ben5049/Robotics-101-Devkit/PCB/101 PCB/101 Models/SK34-TP.stp

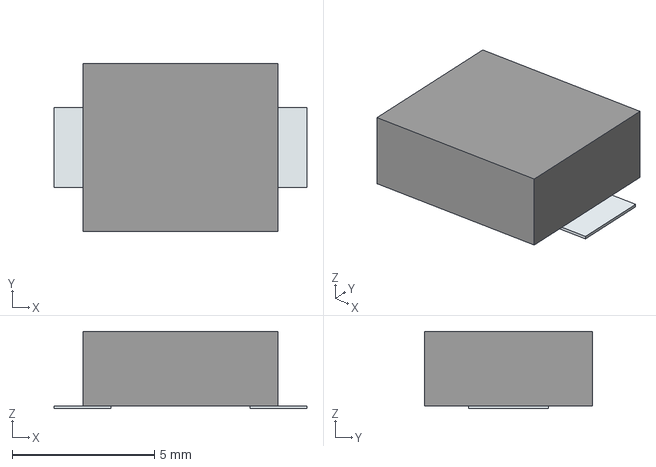
[picture p1: CAD file, 2023-09-11]
PCB/101 PCB/101 Models/SK34-TP.stp
8.90 x 5.90 x 2.72 mm
Pins
