ben5049/Robotics-101-Devkit/PCB/101 PCB/101 Models/DMP3028LFDE-13.STEP

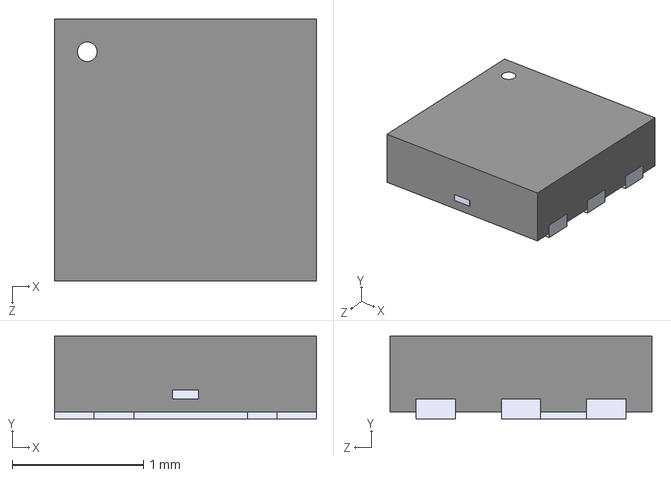
[picture p2: CAD file, 2023-07-07]
PCB/101 PCB/101 Models/DMP3028LFDE-13.STEP
2.00 x 0.63 x 2.00 mm
