ben5049/Robotics-101-Devkit/PCB/101 PCB/101 Models/STM32G030F6P6.stp

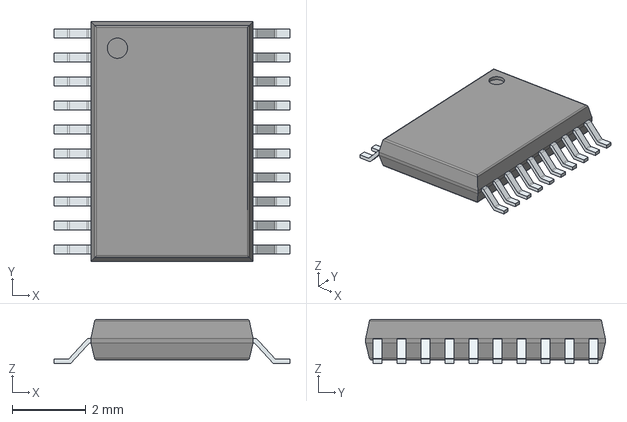
[picture p3: CAD file, 2023-07-05]
PCB/101 PCB/101 Models/STM32G030F6P6.stp
6.40 x 6.50 x 1.20 mm
PinsArrayLR
