ben5049/Robotics-101-Devkit/PCB/101 PCB/101 Models/DRV8837DSGR.stp

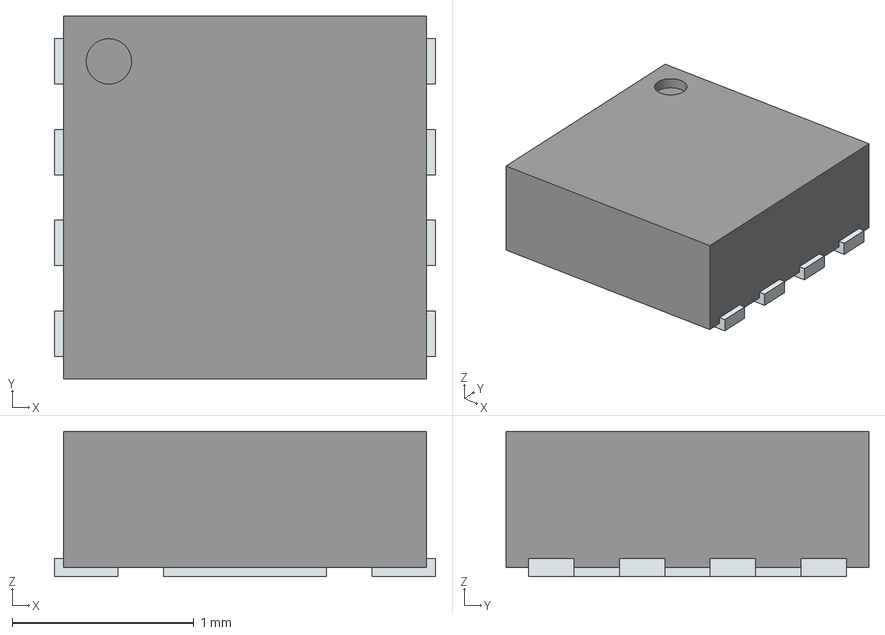
[picture p4: CAD file, 2023-07-05]
PCB/101 PCB/101 Models/DRV8837DSGR.stp
2.10 x 2.00 x 0.8 mm
ThermalPin
PinsArrayLR
