ben5049/Robotics-101-Devkit/PCB/101 PCB/101 Models/ESP32-WROVER-I--3DModel-STEP-56544.STEP

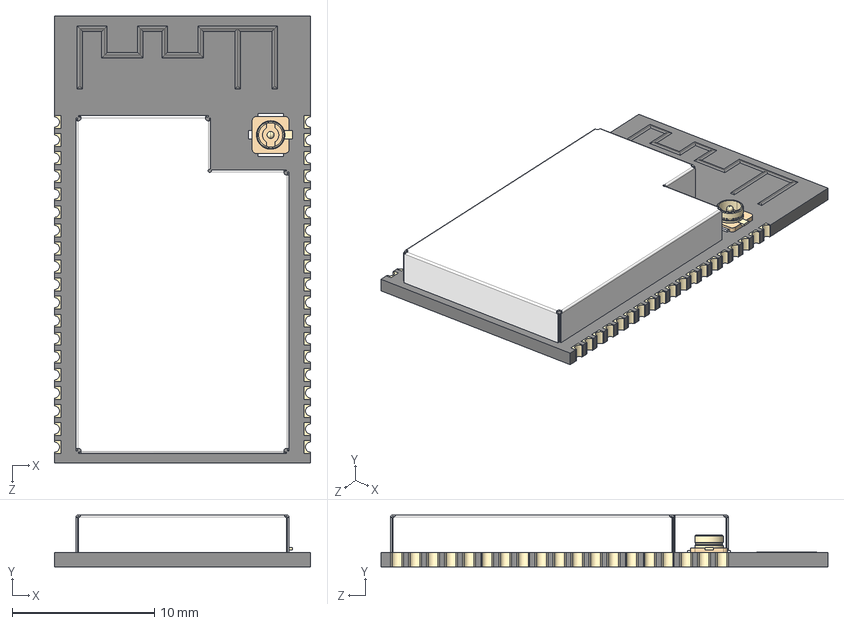
[picture p5: CAD file, 2023-07-05]
PCB/101 PCB/101 Models/ESP32-WROVER-I--3DModel-STEP-56544.STEP
18.0 x 3.65 x 31.4 mm
