ben5049/Robotics-101-Devkit/PCB/101 PCB/101 Models/TYPE-C-31-M-12.step

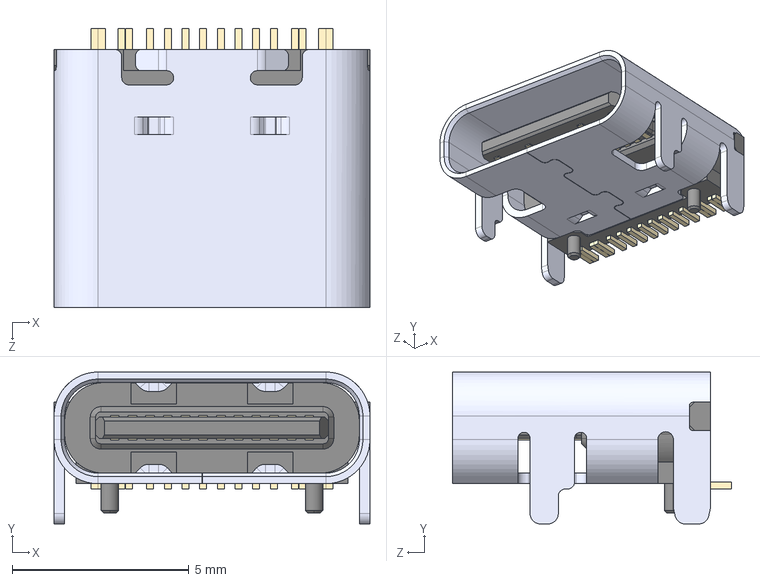
[picture p6: CAD file, 2023-07-05]
PCB/101 PCB/101 Models/TYPE-C-31-M-12.step
8.94 x 4.30 x 7.90 mm
