ben5049/Robotics-101-Devkit/PCB/101 PCB/101 Models/Screw-Terminal-P5.08.step

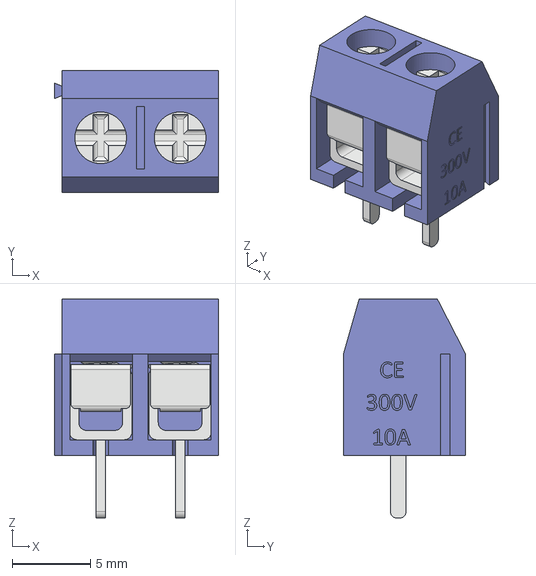
[picture p7: CAD file, 2023-09-11]
PCB/101 PCB/101 Models/Screw-Terminal-P5.08.step
10.5 x 7.80 x 14.0 mm
