ben5049/Robotics-101-Devkit/PCB/101 PCB/101 Models/1760510000.stp

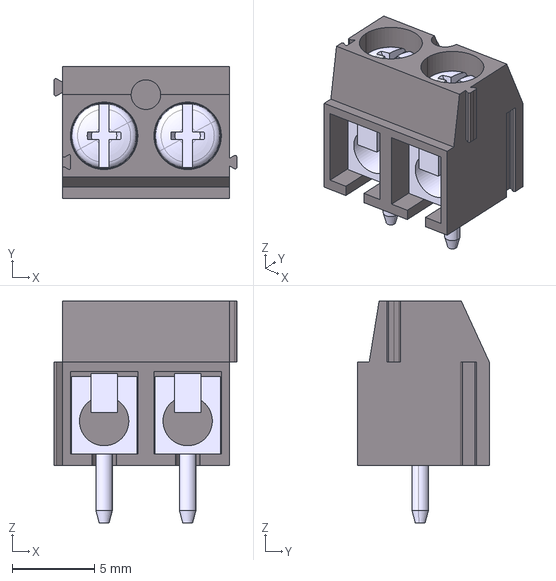
[picture p8: CAD file, 2023-07-05]
PCB/101 PCB/101 Models/1760510000.stp
11.1 x 8.00 x 13.5 mm
