ben5049/Robotics-101-Devkit/PCB/101 PCB/101 Models/TPS563202DRLR.stp

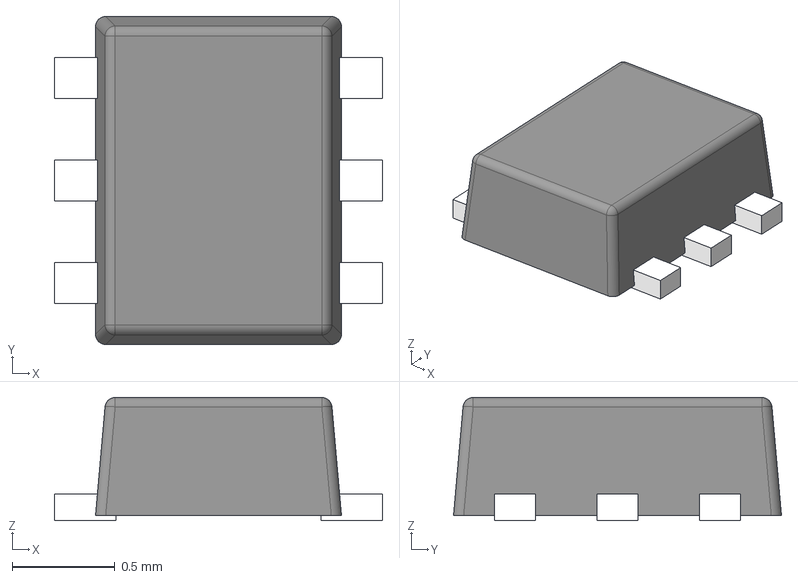
[picture p9: CAD file, 2023-07-05]
PCB/101 PCB/101 Models/TPS563202DRLR.stp
1.60 x 1.60 x 0.6 mm
FRAME-DRL0006A
BODY-SOT
PIN1-ID
