ben5049/Robotics-101-Devkit/PCB/101 PCB/101 PCB.kicad_pcb

## KiCad design PCB/101 PCB/101 PCB.kicad_pcb (2023-09-11)

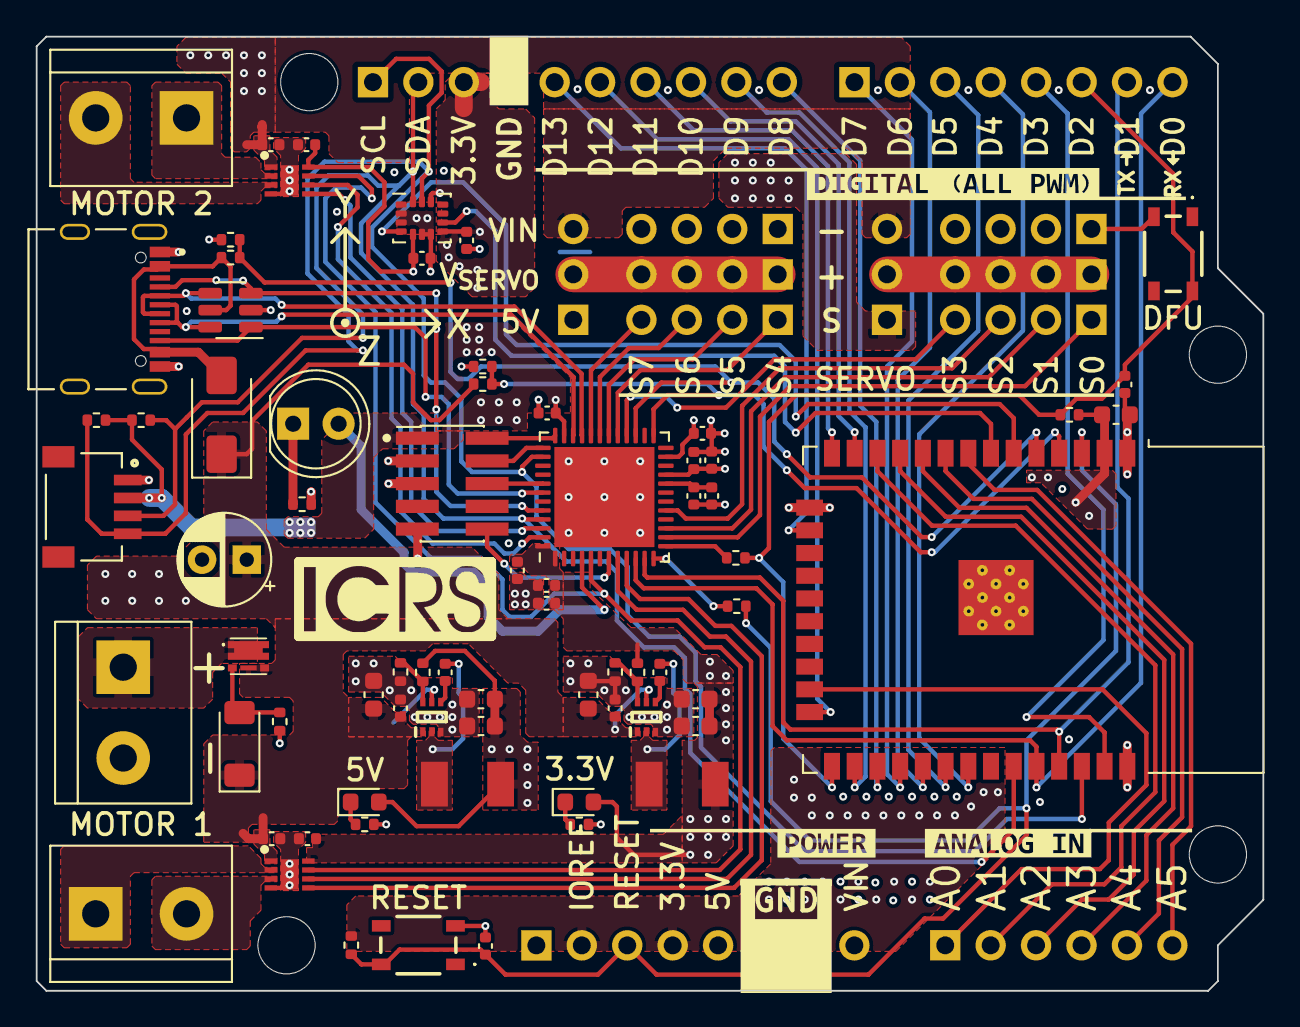
[picture p10: board 101 PCB.kicad_pcb from above]

Board: 4 copper layers, 68.6 x 53.3 mm, 84 parts (1 on the bottom side), 74 nets.

Parts:
A101: Arduino_UNO_R3; ICRS_101_UNO_R3_NO_PINS
C1, C101, C102, C107, C108, C111, C112, C113, C114, C115, C116, C117, C118, C120, C121, C122, C123, C126: 100n; C_0402_1005Metric
C2, C103, C104, C105, C106, C109, C110: 22u; C_0603_1608Metric
C119: 47u; CP_Radial_D5.0mm_P2.50mm
C124: 4u7; C_0402_1005Metric
C125, C127: 1u; C_0402_1005Metric
D1: LED_R; LED_D5.0mm
D2: SK34
D101, D102: GREEN; LED_0603_1608Metric
D104: ZMM10V; D_MiniMELF
IC101, IC103: TPS563202DRLR; SOTFL50P160X60-6N
IC104, IC105: DRV8837DSGR; SON50P200X200X80-9N
J1: Conn_01x10; PinHeader_1x10_P2.54mm_Vertical
J2: Conn_ARM_JTAG_SWD_10; PinHeader_2x05_P1.27mm_Vertical_SMD
J3, J4: Conn_01x08; PinHeader_1x08_P2.54mm_Vertical
J5: Conn_01x06; PinHeader_1x06_P2.54mm_Vertical
J101: TYPE-C-31-M-12; HRO_TYPE-C-31-M-12
J102, J103, J110: Screw_Terminal_01x02; TerminalBlock_bornier-2_P5.08mm
J104, J105, J106, J107, J108, J109: Conn_01x04; PinHeader_1x04_P2.54mm_Vertical
J111: SM04B-SRSS-TB(LF)(SN); JST_SM04B-SRSS-TB(LF)(SN)
JP101, JP102: Jumper_3_Bridged12; PinHeader_1x03_P2.54mm_Vertical
L101: 4u7; L_Chilisin_BMRA00040415
L102: 3u3; L_Chilisin_BMRA00040415
Q101: DMP3028LFDE; DMP2066UFDE7
R1, R107, R109, R111: 10k; R_0402_1005Metric
R2, R3, R106, R108, R114: 330R; R_0402_1005Metric
R4, R5: 2k2; R_0402_1005Metric
R101: 27k; R_0402_1005Metric
R102, R105: 5k1; R_0402_1005Metric
R103: 1k2; R_0402_1005Metric
R104: 16k; R_0402_1005Metric
R110, R112: 1k; R_0402_1005Metric
S101, S102: TS20-42-25-WT-160-SMT-TR; TS204225WT160SMTTRMSL
U101: ESP32-WROOM-32
U103: USBLC6-4SC6-ES; SOT-23-6
U104: LSM6DS3; LGA-14_3x2.5mm_P0.5mm_LayoutBorder3x4y
U106: STM32G431CBUx; QFN-48-1EP_7x7mm_P0.5mm_EP5.6x5.6mm

Connections:
+3.3V: C2.1, C109.1, C110.1, C111.1, C112.1, C113.1, C115.1, C117.1, C120.1, C121.1, C122.1, C123.1, C124.1, C125.1, D102.2 (A), IC104.8 (VCC), IC105.8 (VCC), J1.3, J2.1 (VTref), J4.2, J4.4, J111.2, L102.2, R1.2, R4.2, R5.2, R104.1, R107.2, U101.2 (VDD), U104.5 (VDDIO), U104.8 (VDD), U104.12 (CS), U106.1 (VBAT), U106.21 (VDDA), U106.23 (VDD), U106.35 (VDD), U106.48 (VDD)
+5V: C103.1, C104.1, D101.2 (A), J4.5, JP101.1 (A), JP102.1 (A), L101.2, R101.1
+BATT: J110.1, Q101.1 (D_1), Q101.2 (D_2), Q101.5 (D_3), Q101.6 (D_4), Q101.8 (D_5)
/3V3_BST: C108.1, IC103.4 (BST)
/3V3_FB: IC103.6 (FB), R104.2, R105.1
/3V3_LED_K: D102.1 (K), R106.1
/3V3_SW: C108.2, IC103.2 (SW), L102.1
/5V_BST: C101.1, IC101.4 (BST)
/5V_FB: IC101.6 (FB), R101.2, R102.1
/5V_LED_K: D101.1 (K), R103.1
/5V_SW: C101.2, IC101.2 (SW), L101.1
/M1_OUT1: IC104.2 (OUT1), J102.1
/M1_OUT2: IC104.3 (OUT2), J102.2
/M2_OUT1: IC105.2 (OUT1), J103.1
/M2_OUT2: IC105.3 (OUT2), J103.2
/RP_PMOS_G: D104.2 (A), Q101.3 (G), R108.1
/STM32_EN: R114.1, U106.12 (PA4)
/STM32_IO0: R2.1, U106.13 (PA5)
/STM_LED_A: D1.2 (A), U106.4 (PC15)
/STM_LED_K: D1.1 (K), R3.2
CC1: J101.A5 (CC1), U103.3 (IO2), U106.44 (PB6)
CC2: J101.B5 (CC2), U103.1 (IO1), U106.42 (PB4)
EN: C118.1, J4.3, R107.1, R114.2, S101.2 (NO_2), U101.3 (EN)
ESP32_RX: J3.8, U101.34 (RXD0/IO3), U106.10 (PA2)
ESP32_TX: J3.7, U101.35 (TXD0/IO1), U106.11 (PA3)
GND: C1.2, C2.2, C102.2, C103.2, C104.2, C105.2, C106.2, C107.2, C109.2, C110.2, C111.2, C112.2, C113.2, C114.2, C115.2, C116.2, C117.2, C118.2, C119.2, C120.2, C121.2, C122.2, C123.2, C124.2, C125.2, C126.2, C127.2, IC101.3 (GND), IC103.3 (GND), IC104.4 (GND), IC104.9 (GND), IC105.4 (GND), IC105.9 (GND), J1.4, J2.3 (GND), J2.5 (GND), J2.9 (GNDDetect), J4.6, J4.7, J101.A1_B12 (GND), J101.B1_A12 (GND), J108.1, J108.2, J108.3, J108.4, J109.1, J109.2, J109.3, J109.4, J110.2, J111.1, R3.1, R102.2, R103.2, R105.2, R106.2, R108.2, R110.2, R112.2, S101.3 (COM_1), S102.3 (COM_1), U101.1 (GND), U101.15 (GND), U101.38 (GND), U101.39 (GND), U103.2 (GND), U104.1 (SDO/SA0), U104.2 (SDX), U104.3 (SCX), U104.6 (GND), U104.7 (GND), U106.49 (VSS)
GPIO2: J1.6, U101.24 (IO2)
GPIO4: J1.9, U101.26 (IO4)
GPIO5: J3.2, U101.29 (IO5)
GPIO12: J1.7, U101.14 (IO12)
GPIO13: J1.5, U101.16 (IO13)
GPIO14: J1.8, U101.13 (IO14)
GPIO15: J5.1, U101.23 (IO15)
GPIO16: J1.10, U101.27 (IO16)
GPIO17: J3.1, U101.28 (IO17)
GPIO18: J3.3, U101.30 (IO18)
GPIO19: J3.4, U101.31 (IO19)
GPIO23: J3.5, U101.37 (IO23)
GPIO25: J5.4, U101.10 (IO25)
GPIO26: J5.3, U101.11 (IO26)
GPIO27: J5.2, U101.12 (IO27)
GPIO32: J5.6, U101.8 (IO32)
GPIO33: J5.5, U101.9 (IO33)
IMU_INT1: U101.6 (IO34), U104.4 (INT1)
IMU_INT2: U101.7 (IO35), U104.9 (INT2)
IO0: C1.1, J3.6, R1.1, R2.2, S102.2 (NO_2), U101.25 (IO0)
M1_IN1: IC104.6 (IN1), U106.8 (PA0)
M1_IN2: IC104.5 (IN2), U106.9 (PA1)
M2_IN1: IC105.6 (IN1), U106.47 (PB9)
M2_IN2: IC105.5 (IN2), U106.46 (PB8)
MOTOR_SLEEP: IC104.7 (~SLEEP), IC105.7 (~SLEEP), U106.5 (PF0)
NRST: J2.10 (~RESET), U106.7 (PG10)
S0: J104.1, U106.14 (PA6)
S1: J104.2, U106.15 (PA7)
S2: J104.3, U106.17 (PB0)
S3: J104.4, U106.28 (PB15)
S4: J105.1, U106.29 (PC6)
S5: J105.2, U106.30 (PA8)
S6: J105.3, U106.31 (PA9)
S7: J105.4, U106.32 (PA10)
SCL: J1.1, J111.4, R5.1, U101.36 (IO22), U104.13 (SCL), U106.38 (PA15)
SDA: J1.2, J111.3, R4.1, U101.33 (IO21), U104.14 (SDA), U106.45 (PB7)
SWCLK: J2.4 (SWDCLK/TCK), U106.37 (PA14)
SWDIO: J2.2 (SWDIO/TMS), U106.36 (PA13)
SWO: J2.6 (SWO/TDO), U106.41 (PB3)
USB_DN: J101.A7 (DN1), J101.B7 (DN2), U103.4 (IO3), U106.33 (PA11)
USB_DP: J101.A6 (DP1), J101.B6 (DP2), U103.6 (IO4), U106.34 (PA12)
VBUS: D2.2 (A), J101.A4_B9 (VBUS), J101.B4_A9 (VBUS), R109.1, U103.5 (VBUS)
VBUS/11: R109.2, R110.1, U101.5 (SENSOR_VN), U106.27 (PB14)
VDDIO1: J106.1, J106.2, J106.3, J106.4, JP101.2 (C)
VDDIO2: J107.1, J107.2, J107.3, J107.4, JP102.2 (C)
VIN: C102.1, C105.1, C106.1, C107.1, C114.1, C116.1, C119.1, D2.1 (K), D104.1 (K), IC101.1 (VIN), IC101.5 (EN), IC103.1 (VIN), IC103.5 (EN), IC104.1 (VM), IC105.1 (VM), J4.8, JP101.3 (B), JP102.3 (B), Q101.4 (S_1), Q101.7 (S_2), R111.1
VIN/11: R111.2, R112.1, U101.4 (SENSOR_VP), U106.25 (PB12)
VREF+: C126.1, C127.1, U106.20 (VREF+)
