ben5049/Robotics-101-Devkit/STM32 Firmware/Robotics 101 Devkit Coprocessor/Core/Src/main.c

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
/* Includes ------------------------------------------------------------------*/
#include "app_threadx.h"
#include "main.h"

ADC_HandleTypeDef hadc1;

I2C_HandleTypeDef hi2c1;

TIM_HandleTypeDef htim1;
TIM_HandleTypeDef htim2;
TIM_HandleTypeDef htim3;
TIM_HandleTypeDef htim7;
TIM_HandleTypeDef htim8;
TIM_HandleTypeDef htim15;
TIM_HandleTypeDef htim16;

UART_HandleTypeDef huart2;
DMA_HandleTypeDef hdma_usart2_tx;

PCD_HandleTypeDef hpcd_USB_FS;

/* USER CODE BEGIN PV */
uint8_t ESP32_EN_state = ESP32_EN_NOPUT;
/* USER CODE END PV */

void SystemClock_Config(void);
static void MX_GPIO_Init(void);
static void MX_DMA_Init(void);
static void MX_TIM3_Init(void);
static void MX_ADC1_Init(void);
static void MX_TIM1_Init(void);
static void MX_TIM15_Init(void);
static void MX_TIM16_Init(void);
/**
  * @brief  The application entry point.
  * @retval int
  */
int main(void)
{
  /* MCU Configuration--------------------------------------------------------*/

  /* Reset of all peripherals, Initializes the Flash interface and the Systick. */
  HAL_Init();

  /* Configure the system clock */
  SystemClock_Config();

  /* Initialize all configured peripherals */
  MX_GPIO_Init();
  MX_DMA_Init();
  MX_I2C1_Init();
  MX_TIM2_Init();
  MX_TIM3_Init();
  MX_TIM8_Init();
  MX_ADC1_Init();
  MX_TIM1_Init();
  MX_TIM15_Init();
  MX_TIM16_Init();
  MX_TIM7_Init();
  /* USER CODE BEGIN 2 */

	/* Start pins in known states */
	HAL_GPIO_WritePin(ESP32_IO0_GPIO_Port, ESP32_IO0_Pin, GPIO_PIN_SET);
	HAL_GPIO_WritePin(LED_BUILTIN_GPIO_Port, LED_BUILTIN_Pin, GPIO_PIN_RESET);
//	HAL_GPIO_WritePin(ESP32_EN_GPIO_Port, ESP32_EN_Pin, GPIO_PIN_SET);
	HAL_GPIO_WritePin(MOTOR_SLEEP_GPIO_Port, MOTOR_SLEEP_Pin, GPIO_PIN_RESET);

  /* USER CODE END 2 */

  MX_ThreadX_Init();

  /* We should never get here as control is now taken by the scheduler */
  /* Infinite loop */
  /* USER CODE BEGIN WHILE */
	while (1)
	{
    /* USER CODE END WHILE */

    /* USER CODE BEGIN 3 */
	}
  /* USER CODE END 3 */
}

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
/* USER CODE BEGIN 4 */

void ESP32_EN_switch(uint8_t mode){

//	printf(mode);
	GPIO_InitTypeDef GPIO_InitStruct = {0};

	/* De-initialise pin if initialised */
	if ((ESP32_EN_state != ESP32_EN_NOPUT) && (ESP32_EN_state != mode)){
		HAL_GPIO_DeInit(ESP32_EN_GPIO_Port, ESP32_EN_Pin);
	}

	/* Disable interrupt if enabled */
	if ((ESP32_EN_state == ESP32_EN_INT) && (mode != ESP32_EN_INT)){
		HAL_NVIC_DisableIRQ(EXTI4_IRQn);
	}

	/* Configure ESP32_EN as an input */
	if ((mode == ESP32_EN_INPUT) && (ESP32_EN_state != ESP32_EN_INPUT)){

		/*Configure GPIO pins : ESP32_EN_Pin */
		GPIO_InitStruct.Pin = ESP32_EN_Pin;
		GPIO_InitStruct.Mode = GPIO_MODE_INPUT;
		GPIO_InitStruct.Pull = GPIO_NOPULL;
		HAL_GPIO_Init(ESP32_EN_GPIO_Port, &GPIO_InitStruct);

		ESP32_EN_state = ESP32_EN_INPUT;
	}

	/* Configure ESP32_EN as an output */
	else if ((mode == ESP32_EN_OUTPUT) && (ESP32_EN_state != ESP32_EN_OUTPUT)){

		/*Configure GPIO pins : ESP32_EN_Pin */
		GPIO_InitStruct.Pin = ESP32_EN_Pin;
		GPIO_InitStruct.Mode = GPIO_MODE_OUTPUT_OD;
		GPIO_InitStruct.Pull = GPIO_NOPULL;
		GPIO_InitStruct.Speed = GPIO_SPEED_FREQ_LOW;
		HAL_GPIO_Init(ESP32_EN_GPIO_Port, &GPIO_InitStruct);

		ESP32_EN_state = ESP32_EN_OUTPUT;
	}

	/* Configure ESP32_EN as an external interrupt */
	else if ((mode == ESP32_EN_INT) && (ESP32_EN_state != ESP32_EN_INT)){

		/*Configure GPIO pin : ESP32_EN_Pin */
		GPIO_InitStruct.Pin = ESP32_EN_Pin;
		GPIO_InitStruct.Mode = GPIO_MODE_IT_FALLING;
		GPIO_InitStruct.Pull = GPIO_NOPULL;
		HAL_GPIO_Init(ESP32_EN_GPIO_Port, &GPIO_InitStruct);

		/* EXTI interrupt init */
		HAL_NVIC_SetPriority(EXTI4_IRQn, 0, 0);
		HAL_NVIC_EnableIRQ(EXTI4_IRQn);

		ESP32_EN_state = ESP32_EN_INT;
	}
}

void HAL_GPIO_EXTI_Callback(uint16_t GPIO_Pin)
{
	/* Trigger a system reset when ESP32_EN interrupt fires */
    if(GPIO_Pin == ESP32_EN_Pin)
    {
    	HAL_NVIC_SystemReset();
    }
}

int _write(int file, char *ptr, int len)
{
  (void)file;
  int DataIdx;

  for (DataIdx = 0; DataIdx < len; DataIdx++)
  {
    ITM_SendChar(*ptr++);
  }
  return len;
}

/* USER CODE END 4 */

/**
  * @brief  Period elapsed callback in non blocking mode
  * @note   This function is called  when TIM6 interrupt took place, inside
  * HAL_TIM_IRQHandler(). It makes a direct call to HAL_IncTick() to increment
  * a global variable "uwTick" used as application time base.
  * @param  htim : TIM handle
  * @retval None
  */
void HAL_TIM_PeriodElapsedCallback(TIM_HandleTypeDef *htim)
{
  if (htim->Instance == TIM6) {
    HAL_IncTick();
  }
  /* USER CODE BEGIN Callback 1 */

	/* Timer 7 is used to delay a reset signal to ESP32 */

	if (htim->Instance == TIM7) {
		HAL_TIM_Base_Stop_IT(&htim7);
		__HAL_TIM_SET_COUNTER(&htim7, 0);
		HAL_GPIO_WritePin(ESP32_IO0_GPIO_Port, ESP32_IO0_Pin, GPIO_PIN_SET);
		//    HAL_GPIO_WritePin(ESP32_EN_GPIO_Port, ESP32_EN_Pin, GPIO_PIN_SET);
	}

  /* USER CODE END Callback 1 */
}

/**
  * @brief  This function is executed in case of error occurrence.
  * @retval None
  */
void Error_Handler(void)
{
  /* USER CODE BEGIN Error_Handler_Debug */
	/* User can add their own implementation to report the HAL error return state */
	__disable_irq();
	while (1)
	{
	}
  /* USER CODE END Error_Handler_Debug */
}

#ifdef  USE_FULL_ASSERT
/**
  * @brief  Reports the name of the source file and the source line number
  *         where the assert_param error has occurred.
  * @param  file: pointer to the source file name
  * @param  line: assert_param error line source number
  * @retval None
  */
void assert_failed(uint8_t *file, uint32_t line)
{
  /* USER CODE BEGIN 6 */
	/* User can add his own implementation to report the file name and line number,
     ex: printf("Wrong parameters value: file %s on line %d\r\n", file, line) */
  /* USER CODE END 6 */
}
#endif /* USE_FULL_ASSERT */
