ben5049/Robotics-101-Devkit/STM32 Firmware/Robotics 101 Devkit Coprocessor/Robotics 101 Devkit Coprocessor.ioc

Mcu.UserName=STM32G431CBUx
PA0.GPIO_Label=M1_IN1
PA0.Signal=S_TIM2_CH1
PA1.GPIO_Label=M1_IN2
PA1.Signal=S_TIM2_CH2
PA10.GPIO_Label=S7
PA10.Signal=S_TIM1_CH3
PA11.Signal=USB_DM
PA12.Signal=USB_DP
PA13.Signal=SYS_JTMS-SWDIO
PA14.Signal=SYS_JTCK-SWCLK
PA15.Signal=I2C1_SCL
PA2.Signal=USART2_TX
PA3.Signal=USART2_RX
PA4.GPIO_Label=ESP32_EN
PA4.Signal=SharedStack_PA4
PA5.GPIO_Label=ESP32_IO0
PA5.Signal=GPIO_Output
PA6.GPIO_Label=S0
PA6.Signal=S_TIM16_CH1
PA7.GPIO_Label=S1
PA7.Signal=S_TIM3_CH2
PA8.GPIO_Label=S5
PA8.Signal=S_TIM1_CH1
PA9.GPIO_Label=S6
PA9.Signal=S_TIM1_CH2
PB0.GPIO_Label=S2
PB0.Signal=S_TIM3_CH3
PB12.GPIO_Label=VIN/11
PB12.Signal=ADC1_IN11
PB14.GPIO_Label=VBUS/11
PB14.Signal=ADC1_IN5
PB15.GPIO_Label=S3
PB15.Signal=S_TIM15_CH2
PB3.Signal=SYS_JTDO-SWO
PB4.Signal=UCPD1_CC2
PB6.Signal=UCPD1_CC1
PB7.Signal=I2C1_SDA
PB8-BOOT0.GPIO_Label=M2_IN2
PB8-BOOT0.Signal=S_TIM8_CH2
PB9.GPIO_Label=M2_IN1
PB9.Signal=S_TIM8_CH3
PC15-OSC32_OUT.GPIO_Label=LED_BUILTIN
PC15-OSC32_OUT.Signal=GPIO_Output
PC6.GPIO_Label=S4
PC6.Signal=S_TIM3_CH1
PF0-OSC_IN.GPIO_Label=MOTOR_SLEEP
PF0-OSC_IN.Signal=GPIO_Output
