ben5049/Robotics-101-Devkit/STM32 Firmware/Robotics 101 Devkit Coprocessor/Core/Inc/main.h

#define LED_BUILTIN_Pin GPIO_PIN_15
#define LED_BUILTIN_GPIO_Port GPIOC
#define MOTOR_SLEEP_Pin GPIO_PIN_0
#define MOTOR_SLEEP_GPIO_Port GPIOF
#define M1_IN1_Pin GPIO_PIN_0
#define M1_IN1_GPIO_Port GPIOA
#define M1_IN2_Pin GPIO_PIN_1
#define M1_IN2_GPIO_Port GPIOA
#define ESP32_EN_Pin GPIO_PIN_4
#define ESP32_EN_GPIO_Port GPIOA
#define ESP32_IO0_Pin GPIO_PIN_5
#define ESP32_IO0_GPIO_Port GPIOA
#define S0_Pin GPIO_PIN_6
#define S0_GPIO_Port GPIOA
#define S1_Pin GPIO_PIN_7
#define S1_GPIO_Port GPIOA
#define S2_Pin GPIO_PIN_0
#define S2_GPIO_Port GPIOB
#define VIN_11_Pin GPIO_PIN_12
#define VIN_11_GPIO_Port GPIOB
#define VBUS_11_Pin GPIO_PIN_14
#define VBUS_11_GPIO_Port GPIOB
#define S3_Pin GPIO_PIN_15
#define S3_GPIO_Port GPIOB
#define S4_Pin GPIO_PIN_6
#define S4_GPIO_Port GPIOC
#define S5_Pin GPIO_PIN_8
#define S5_GPIO_Port GPIOA
#define S6_Pin GPIO_PIN_9
#define S6_GPIO_Port GPIOA
#define S7_Pin GPIO_PIN_10
#define S7_GPIO_Port GPIOA
#define M2_IN2_Pin GPIO_PIN_8
#define M2_IN2_GPIO_Port GPIOB
#define M2_IN1_Pin GPIO_PIN_9
#define M2_IN1_GPIO_Port GPIOB
#define ESP32_EN_NOPUT 0x00
#define ESP32_EN_INPUT 0x01
#define ESP32_EN_OUTPUT 0x02
#define ESP32_EN_INT 0x03
