ben5049/Robotics-101-Devkit/STM32 Firmware/Robotics 101 Devkit Coprocessor/USBX/App/app_usbx_device.c

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

/* Includes ------------------------------------------------------------------*/
#include "app_usbx_device.h"


static ULONG cdc_acm_interface_number;
static ULONG cdc_acm_configuration_number;
static UX_SLAVE_CLASS_CDC_ACM_PARAMETER cdc_acm_parameter;
static TX_THREAD ux_device_app_thread;

/* USER CODE BEGIN PV */

static TX_THREAD ux_cdc_read_thread;
static TX_THREAD ux_cdc_write_thread;
TX_EVENT_FLAGS_GROUP EventFlag;
extern UART_HandleTypeDef huart1;
extern PCD_HandleTypeDef hpcd_USB_FS;

/* USER CODE END PV */

static VOID app_ux_device_thread_entry(ULONG thread_input);
/**
  * @brief  Application USBX Device Initialization.
  * @param  memory_ptr: memory pointer
  * @retval status
  */
UINT MX_USBX_Device_Init(VOID *memory_ptr)
{
  UINT ret = UX_SUCCESS;
  UCHAR *device_framework_high_speed;
  UCHAR *device_framework_full_speed;
  ULONG device_framework_hs_length;
  ULONG device_framework_fs_length;
  ULONG string_framework_length;
  ULONG language_id_framework_length;
  UCHAR *string_framework;
  UCHAR *language_id_framework;
  UCHAR *pointer;
  TX_BYTE_POOL *byte_pool = (TX_BYTE_POOL*)memory_ptr;

  /* Allocate the stack for USBX Memory */
  if (tx_byte_allocate(byte_pool, (VOID **) &pointer,
                       USBX_DEVICE_MEMORY_STACK_SIZE, TX_NO_WAIT) != TX_SUCCESS)
  {
    /* USER CODE BEGIN USBX_ALLOCATE_STACK_ERORR */
	return TX_POOL_ERROR;
    /* USER CODE END USBX_ALLOCATE_STACK_ERORR */
  }

  /* Initialize USBX Memory */
  if (ux_system_initialize(pointer, USBX_DEVICE_MEMORY_STACK_SIZE, UX_NULL, 0) != UX_SUCCESS)
  {
    /* USER CODE BEGIN USBX_SYSTEM_INITIALIZE_ERORR */
	return UX_ERROR;
    /* USER CODE END USBX_SYSTEM_INITIALIZE_ERORR */
  }

  /* Get Device Framework High Speed and get the length */
  device_framework_high_speed = USBD_Get_Device_Framework_Speed(USBD_HIGH_SPEED,
                                                                &device_framework_hs_length);

  /* Get Device Framework Full Speed and get the length */
  device_framework_full_speed = USBD_Get_Device_Framework_Speed(USBD_FULL_SPEED,
                                                                &device_framework_fs_length);

  /* Get String Framework and get the length */
  string_framework = USBD_Get_String_Framework(&string_framework_length);

  /* Get Language Id Framework and get the length */
  language_id_framework = USBD_Get_Language_Id_Framework(&language_id_framework_length);

  /* Install the device portion of USBX */
  if (ux_device_stack_initialize(device_framework_high_speed,
                                 device_framework_hs_length,
                                 device_framework_full_speed,
                                 device_framework_fs_length,
                                 string_framework,
                                 string_framework_length,
                                 language_id_framework,
                                 language_id_framework_length,
                                 UX_NULL) != UX_SUCCESS)
  {
    /* USER CODE BEGIN USBX_DEVICE_INITIALIZE_ERORR */
	return UX_ERROR;
    /* USER CODE END USBX_DEVICE_INITIALIZE_ERORR */
  }

  /* Initialize the cdc acm class parameters for the device */
  cdc_acm_parameter.ux_slave_class_cdc_acm_instance_activate   = USBD_CDC_ACM_Activate;
  cdc_acm_parameter.ux_slave_class_cdc_acm_instance_deactivate = USBD_CDC_ACM_Deactivate;
  cdc_acm_parameter.ux_slave_class_cdc_acm_parameter_change    = USBD_CDC_ACM_ParameterChange;

  /* Get cdc acm configuration number */
  cdc_acm_configuration_number = USBD_Get_Configuration_Number(CLASS_TYPE_CDC_ACM, 0);

  /* Find cdc acm interface number */
  cdc_acm_interface_number = USBD_Get_Interface_Number(CLASS_TYPE_CDC_ACM, 0);

  /* Initialize the device cdc acm class */
  if (ux_device_stack_class_register(_ux_system_slave_class_cdc_acm_name,
                                     ux_device_class_cdc_acm_entry,
                                     cdc_acm_configuration_number,
                                     cdc_acm_interface_number,
                                     &cdc_acm_parameter) != UX_SUCCESS)
  {
    /* USER CODE BEGIN USBX_DEVICE_CDC_ACM_REGISTER_ERORR */
	return UX_ERROR;
    /* USER CODE END USBX_DEVICE_CDC_ACM_REGISTER_ERORR */
  }

  /* Allocate the stack for device application main thread */
  if (tx_byte_allocate(byte_pool, (VOID **) &pointer, UX_DEVICE_APP_THREAD_STACK_SIZE,
                       TX_NO_WAIT) != TX_SUCCESS)
  {
    /* USER CODE BEGIN MAIN_THREAD_ALLOCATE_STACK_ERORR */
	return TX_POOL_ERROR;
    /* USER CODE END MAIN_THREAD_ALLOCATE_STACK_ERORR */
  }

  /* Create the device application main thread */
  if (tx_thread_create(&ux_device_app_thread, UX_DEVICE_APP_THREAD_NAME, app_ux_device_thread_entry,
                       0, pointer, UX_DEVICE_APP_THREAD_STACK_SIZE, UX_DEVICE_APP_THREAD_PRIO,
                       UX_DEVICE_APP_THREAD_PREEMPTION_THRESHOLD, UX_DEVICE_APP_THREAD_TIME_SLICE,
                       UX_DEVICE_APP_THREAD_START_OPTION) != TX_SUCCESS)
  {
    /* USER CODE BEGIN MAIN_THREAD_CREATE_ERORR */
	  return TX_THREAD_ERROR;
    /* USER CODE END MAIN_THREAD_CREATE_ERORR */
  }

  /* USER CODE BEGIN MX_USBX_Device_Init1 */

  /* Allocate the stack for usbx cdc acm read thread */
  if (tx_byte_allocate(byte_pool, (VOID **) &pointer, 1024, TX_NO_WAIT) != TX_SUCCESS)
  {
    return TX_POOL_ERROR;
  }

  /* Create the usbx cdc acm read thread */
  if (tx_thread_create(&ux_cdc_read_thread, "cdc_acm_read_usbx_app_thread_entry",
                       usbx_cdc_acm_read_thread_entry, 1, pointer,
                       1024, 20, 20, TX_NO_TIME_SLICE,
                       TX_AUTO_START) != TX_SUCCESS)
  {
    return TX_THREAD_ERROR;
  }

  /* Allocate the stack for usbx cdc acm write thread */
  if (tx_byte_allocate(byte_pool, (VOID **) &pointer, 1024, TX_NO_WAIT) != TX_SUCCESS)
  {
    return TX_POOL_ERROR;
  }

  /* Create the usbx_cdc_acm_write_thread_entry thread */
  if (tx_thread_create(&ux_cdc_write_thread, "cdc_acm_write_usbx_app_thread_entry",
                       usbx_cdc_acm_write_thread_entry, 1, pointer,
                       1024, 20, 20, TX_NO_TIME_SLICE,
                       TX_AUTO_START) != TX_SUCCESS)
  {
    return TX_THREAD_ERROR;
  }

  /* Create the event flags group */
  if (tx_event_flags_create(&EventFlag, "Event Flag") != TX_SUCCESS)
  {
    return TX_GROUP_ERROR;
  }

  /* USER CODE END MX_USBX_Device_Init1 */

  return ret;
}

/**
  * @brief  Function implementing app_ux_device_thread_entry.
  * @param  thread_input: User thread input parameter.
  * @retval none
  */
static VOID app_ux_device_thread_entry(ULONG thread_input)
{
  /* USER CODE BEGIN app_ux_device_thread_entry */

	  /* Initialisation of USB device */
	  USBX_APP_Device_Init();

  /* USER CODE END app_ux_device_thread_entry */
}

/* USER CODE BEGIN 1 */


/**
  * @brief  USBX_APP_Device_Init
  *         Initialisation of USB device.
  * @param  none
  * @retval none
  */
VOID USBX_APP_Device_Init(VOID)
{
  /* USB_FS init function */
  MX_USB_PCD_Init();

	/*
	 * TODO: Update table
	 *
	 * Configure packet buffers to receive end point data
	 *
	 * PMA layout:
	 * 	BTABLE:          0x00 -  0x17 (24 bytes)
	 * 	EP0 OUT (0x00):  0x18 -  0x57 (64 bytes)
	 * 	EP0 IN  (0x80):  0x58 -  0x97 (64 bytes)
	 * 	EP1 OUT (0x01):  0x98 -  0xD7 (64 bytes)
	 * 	EP1 IN  (0x81):  0xD8 - 0x1D7 (256 bytes)
	 * 	EP2 OUT (0x02): 0x1D8 - 0x217 (64 bytes)
	 * 	EP2 IN  (0x82): 0x218 - 0x257 (64 bytes)
	 *
	 * BTABLE uses the first 20 bytes of the PMA when the USB peripheral is configured
	 * for 3 end points (EP0, EP1, EP2). For more info, see RM0440 p2008.
	 */

  /* USER CODE BEGIN USB_Device_Init_PreTreatment_1 */
  HAL_PCDEx_PMAConfig(&hpcd_USB_FS, 0x00, PCD_SNG_BUF, 0x14);
  HAL_PCDEx_PMAConfig(&hpcd_USB_FS, 0x80, PCD_SNG_BUF, 0x54);
  /* USER CODE END EndPoint_Configuration */
  /* USER CODE BEGIN EndPoint_Configuration_CDC */
  HAL_PCDEx_PMAConfig(&hpcd_USB_FS, 0x81, PCD_SNG_BUF, 0x94);
  HAL_PCDEx_PMAConfig(&hpcd_USB_FS, 0x01, PCD_SNG_BUF, 0xD4);
  HAL_PCDEx_PMAConfig(&hpcd_USB_FS, 0x82, PCD_SNG_BUF, 0x114);
  /* USER CODE END USB_Device_Init_PreTreatment_1 */

  /* Initialise and link controller HAL driver */
  ux_dcd_stm32_initialize((ULONG)USB, (ULONG)&hpcd_USB_FS);

  /* Start the USB device */
  HAL_PCD_Start(&hpcd_USB_FS);

}

/**
  * @brief  USBX_APP_UART_Init
  *         Initialisation of UART.
  * @param  huart: Pointer to UART handler
  * @retval none
  */
VOID USBX_APP_UART_Init(UART_HandleTypeDef **huart)
{
  /* USER CODE BEGIN USBX_APP_UART_Init */

  MX_USART2_UART_Init();

  *huart = &huart2;

  /* USER CODE END USBX_APP_UART_Init */
}

/* USER CODE END 1 */
