ben5049/Robotics-101-Devkit/STM32 Firmware/Robotics 101 Devkit Coprocessor/USBX/App/ux_device_cdc_acm.c

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

/* Includes ------------------------------------------------------------------*/
#include "ux_device_cdc_acm.h"

/* USER CODE BEGIN PM */

#define APP_RX_DATA_SIZE   2*1024
#define APP_TX_DATA_SIZE   2*1024

/* Rx/TX flag */
#define RX_NEW_RECEIVED_DATA      0x01
#define TX_NEW_TRANSMITTED_DATA   0x02

/* Data length for vcp */
#define VCP_WORDLENGTH8  8
#define VCP_WORDLENGTH9  9

/* the minimum baudrate */
#define MIN_BAUDRATE     9600

/* USER CODE END PM */

/* USER CODE BEGIN PV */

UX_SLAVE_CLASS_CDC_ACM  *cdc_acm;

uint8_t UserRxBufferFS[APP_RX_DATA_SIZE];
uint8_t UserTxBufferFS[APP_TX_DATA_SIZE];

uint32_t UserTxBufPtrIn;
uint32_t UserTxBufPtrOut;

UART_HandleTypeDef *uart_handler;
extern TX_EVENT_FLAGS_GROUP EventFlag;

UX_SLAVE_CLASS_CDC_ACM_LINE_CODING_PARAMETER CDC_VCP_LineCoding =
{
		115200, /* baud rate */
		0x00,   /* stop bits-1 */
		0x00,   /* parity - none */
		0x08    /* nb. of bits 8 */
};

/* USER CODE END PV */

/* USER CODE BEGIN PFP */
extern VOID USBX_APP_UART_Init(UART_HandleTypeDef **huart);
static void USBD_CDC_VCP_Config(UX_SLAVE_CLASS_CDC_ACM_LINE_CODING_PARAMETER *);
/* USER CODE END PFP */

/**
 * @brief  USBD_CDC_ACM_Activate
 *         This function is called when insertion of a CDC ACM device.
 * @param  cdc_acm_instance: Pointer to the cdc acm class instance.
 * @retval none
 */
VOID USBD_CDC_ACM_Activate(VOID *cdc_acm_instance)
{
	/* USER CODE BEGIN USBD_CDC_ACM_Activate */


	/* Save the CDC instance */
	cdc_acm = (UX_SLAVE_CLASS_CDC_ACM*) cdc_acm_instance;

	/* Configure the UART peripheral */
	USBX_APP_UART_Init(&uart_handler);

	/* Get default UART parameters */
	CDC_VCP_LineCoding.ux_slave_class_cdc_acm_parameter_baudrate = uart_handler->Init.BaudRate;

	/* Set the UART data type : only 8bits and 9bits are supported */
	switch (uart_handler->Init.WordLength)
	{
	case UART_WORDLENGTH_8B:
	{
		/* Set UART data bit to 8 */
		CDC_VCP_LineCoding.ux_slave_class_cdc_acm_parameter_data_bit = VCP_WORDLENGTH8;
		break;
	}

	case UART_WORDLENGTH_9B:
	{
		/* Set UART data bit to 9 */
		CDC_VCP_LineCoding.ux_slave_class_cdc_acm_parameter_data_bit = VCP_WORDLENGTH9;
		break;
	}

	default :
	{
		/* By default set UART data bit to 8 */
		CDC_VCP_LineCoding.ux_slave_class_cdc_acm_parameter_data_bit = VCP_WORDLENGTH8;
		break;
	}
	}

	/* Get UART Parity */
	CDC_VCP_LineCoding.ux_slave_class_cdc_acm_parameter_parity = uart_handler->Init.Parity;

	/* Get UART StopBits */
	CDC_VCP_LineCoding.ux_slave_class_cdc_acm_parameter_stop_bit = uart_handler->Init.StopBits;

	/* Set device class_cdc_acm with default parameters */
	if (ux_device_class_cdc_acm_ioctl(cdc_acm, UX_SLAVE_CLASS_CDC_ACM_IOCTL_SET_LINE_CODING,
			&CDC_VCP_LineCoding) != UX_SUCCESS)
	{
		Error_Handler();
	}

	/* Receive an amount of data in interrupt mode */
	if (HAL_UART_Receive_IT(uart_handler, (uint8_t *)UserTxBufferFS, 1) != HAL_OK)
	{
		/* Transfer error in reception process */
		Error_Handler();
	}

	/* USER CODE END USBD_CDC_ACM_Activate */

	return;
}

/**
 * @brief  USBD_CDC_ACM_Deactivate
 *         This function is called when extraction of a CDC ACM device.
 * @param  cdc_acm_instance: Pointer to the cdc acm class instance.
 * @retval none
 */
VOID USBD_CDC_ACM_Deactivate(VOID *cdc_acm_instance)
{
	/* USER CODE BEGIN USBD_CDC_ACM_Deactivate */

	UX_PARAMETER_NOT_USED(cdc_acm_instance);

	/* Reset the cdc acm instance */
	cdc_acm = UX_NULL;

	/* DeInitialize the UART peripheral */
	HAL_UART_DeInit(uart_handler);

	/* USER CODE END USBD_CDC_ACM_Deactivate */

	return;
}

/**
 * @brief  USBD_CDC_ACM_ParameterChange
 *         This function is invoked to manage the CDC ACM class requests.
 * @param  cdc_acm_instance: Pointer to the cdc acm class instance.
 * @retval none
 */
VOID USBD_CDC_ACM_ParameterChange(VOID *cdc_acm_instance)
{
	/* USER CODE BEGIN USBD_CDC_ACM_ParameterChange */

	UX_PARAMETER_NOT_USED(cdc_acm_instance);

	ULONG request;
	UX_SLAVE_TRANSFER *transfer_request;
	UX_SLAVE_DEVICE *device;

	/* Get the pointer to the device */
	device = &_ux_system_slave -> ux_system_slave_device;

	/* Get the pointer to the transfer request associated with the control endpoint */
	transfer_request = &device -> ux_slave_device_control_endpoint.ux_slave_endpoint_transfer_request;

	request = *(transfer_request -> ux_slave_transfer_request_setup + UX_SETUP_REQUEST);

	switch (request)
	{
	case UX_SLAVE_CLASS_CDC_ACM_SET_LINE_CODING :

		/* Get the Line Coding parameters */
		if (ux_device_class_cdc_acm_ioctl(cdc_acm, UX_SLAVE_CLASS_CDC_ACM_IOCTL_GET_LINE_CODING,
				&CDC_VCP_LineCoding) != UX_SUCCESS)
		{
			Error_Handler();
		}

		/* Check if baudrate < 9600) then set it to 9600 */
		if (CDC_VCP_LineCoding.ux_slave_class_cdc_acm_parameter_baudrate < MIN_BAUDRATE)
		{
			CDC_VCP_LineCoding.ux_slave_class_cdc_acm_parameter_baudrate = MIN_BAUDRATE;

			/* Set the new configuration of ComPort */
			USBD_CDC_VCP_Config(&CDC_VCP_LineCoding);
		}
		else
		{
			/* Set the new configuration of ComPort */
			USBD_CDC_VCP_Config(&CDC_VCP_LineCoding);
		}

		break;

	case UX_SLAVE_CLASS_CDC_ACM_GET_LINE_CODING :

		/* Set the Line Coding parameters */
		if (ux_device_class_cdc_acm_ioctl(cdc_acm, UX_SLAVE_CLASS_CDC_ACM_IOCTL_SET_LINE_CODING,
				&CDC_VCP_LineCoding) != UX_SUCCESS)
		{
			Error_Handler();
		}

		break;

	case UX_SLAVE_CLASS_CDC_ACM_SET_CONTROL_LINE_STATE :

		/* Set ESP32 IO0 and EN using on DTR and RTS. Implementation based on ESP32 auto program table (https://user-images.githubusercontent.com/1180107/37556716-20616fd8-29fa-11e8-9542-c7f0d03da3b5.jpg) */

		/* If DTR == 1 and RTS == 1 */
		if ((cdc_acm->ux_slave_class_cdc_acm_data_rts_state == UX_TRUE) && (cdc_acm->ux_slave_class_cdc_acm_data_dtr_state == UX_TRUE)){

			HAL_GPIO_WritePin(ESP32_EN_GPIO_Port, ESP32_EN_Pin, GPIO_PIN_SET);
			ESP32_EN_switch(ESP32_EN_INT);

			__HAL_TIM_SET_COUNTER(&htim7, 0);
			HAL_TIM_Base_Start_IT(&htim7);
		}

		/* If DTR != 1 or RTS != 1 */
		else {
			if (cdc_acm->ux_slave_class_cdc_acm_data_dtr_state == UX_TRUE){
				HAL_GPIO_WritePin(ESP32_IO0_GPIO_Port, ESP32_IO0_Pin, GPIO_PIN_RESET);
				reset_extra_functions();
			}
			else {
				__HAL_TIM_SET_COUNTER(&htim7, 0);
				HAL_TIM_Base_Start_IT(&htim7);
			}

			if (cdc_acm->ux_slave_class_cdc_acm_data_rts_state == UX_TRUE){
				ESP32_EN_switch(ESP32_EN_OUTPUT);
				HAL_GPIO_WritePin(ESP32_EN_GPIO_Port, ESP32_EN_Pin, GPIO_PIN_RESET);
			}
			else {
				HAL_GPIO_WritePin(ESP32_EN_GPIO_Port, ESP32_EN_Pin, GPIO_PIN_SET);
				ESP32_EN_switch(ESP32_EN_INT);
			}




			//	    		if (cdc_acm -> ux_slave_class_cdc_acm_data_rts_state == UX_TRUE){
			//	    			HAL_GPIO_WritePin(ESP32_IO0_GPIO_Port, ESP32_IO0_Pin, GPIO_PIN_RESET);
			//
			//	    			for(int i = 0; i < 1000000; i++);
			//	    			HAL_GPIO_WritePin(ESP32_IO0_GPIO_Port, ESP32_EN_Pin, GPIO_PIN_RESET);
			//
			//
			//	    			for(int i = 0; i < 1000000; i++);
			//	    			HAL_GPIO_WritePin(ESP32_IO0_GPIO_Port, ESP32_EN_Pin, GPIO_PIN_SET);
			//
			//	    			for(int i = 0; i < 1000000; i++);
			//	    			HAL_GPIO_WritePin(ESP32_IO0_GPIO_Port, ESP32_IO0_Pin, GPIO_PIN_SET);
			//
			//	    		}
			////	    		else {
			////	    			HAL_GPIO_WritePin(ESP32_IO0_GPIO_Port, ESP32_IO0_Pin, GPIO_PIN_SET);
			////	    		}
			////
			////
			////	    		if (cdc_acm -> ux_slave_class_cdc_acm_data_dtr_state == UX_TRUE){
			////	    			HAL_GPIO_WritePin(ESP32_IO0_GPIO_Port, ESP32_EN_Pin, GPIO_PIN_RESET);
			////	    		}
			////	    		else {
			////	    			HAL_GPIO_WritePin(ESP32_IO0_GPIO_Port, ESP32_EN_Pin, GPIO_PIN_SET);
			//	    		}
		}

		break;

	default :
		break;
	}
	/* USER CODE END USBD_CDC_ACM_ParameterChange */

	return;
}

/* USER CODE BEGIN 1 */

/**
 * @brief  Function implementing usbx_cdc_acm_thread_entry.
 * @param  thread_input: Not used
 * @retval none
 */
VOID usbx_cdc_acm_read_thread_entry(ULONG thread_input)
{
	ULONG actual_length;
	ULONG senddataflag = 0;
	UX_SLAVE_DEVICE *device;

	UX_PARAMETER_NOT_USED(thread_input);

	device = &_ux_system_slave->ux_system_slave_device;

	while (1)
	{

		/* Check if device is configured */
		if ((device->ux_slave_device_state == UX_DEVICE_CONFIGURED) && (cdc_acm != UX_NULL))
		{

#ifndef UX_DEVICE_CLASS_CDC_ACM_TRANSMISSION_DISABLE

			/* Set transmission_status to UX_FALSE for the first time */
			cdc_acm -> ux_slave_class_cdc_acm_transmission_status = UX_FALSE;

#endif /* UX_DEVICE_CLASS_CDC_ACM_TRANSMISSION_DISABLE */

			/* Read the received data in blocking mode */
			ux_device_class_cdc_acm_read(cdc_acm, (UCHAR *)UserRxBufferFS, 64,
					&actual_length);
			if (actual_length != 0)
			{
				/* Send the data via UART */
				//    	for (uint8_t i = 0; i < actual_length; i++){
				//    		printf("Sent: %d \n", UserRxBufferFS[i]);
				//    	}

				if (HAL_UART_Transmit_DMA(uart_handler, (uint8_t *)UserRxBufferFS, actual_length) != HAL_OK)
				{
					Error_Handler();
				}

				/* Wait until the requested flag TX_NEW_TRANSMITTED_DATA is received */
				if (tx_event_flags_get(&EventFlag, TX_NEW_TRANSMITTED_DATA, TX_OR_CLEAR,
						&senddataflag, TX_WAIT_FOREVER) != TX_SUCCESS)
				{
					Error_Handler();
				}
			}
			else
			{
				/* Sleep thread for 10ms if no data received */
				tx_thread_sleep(MS_TO_TICK(10));
			}
		}
		else
		{
			/* Sleep thread for 10ms */
			tx_thread_sleep(MS_TO_TICK(10));
		}
	}
}

/**
 * @brief  Function implementing usbx_cdc_acm_write_thread_entry.
 * @param  thread_input: Not used
 * @retval none
 */
VOID usbx_cdc_acm_write_thread_entry(ULONG thread_input)
{
	ULONG receivedataflag = 0;
	ULONG actual_length, buffptr, buffsize;

	UX_PARAMETER_NOT_USED(thread_input);

	while (1)
	{

		/* Wait until the requested flag RX_NEW_RECEIVED_DATA is received */
		if (tx_event_flags_get(&EventFlag, RX_NEW_RECEIVED_DATA, TX_OR_CLEAR,
				&receivedataflag, TX_WAIT_FOREVER) != TX_SUCCESS)
		{
			Error_Handler();
		}

#ifndef UX_DEVICE_CLASS_CDC_ACM_TRANSMISSION_DISABLE

		/* Set transmission_status to UX_FALSE for the first time */
		cdc_acm -> ux_slave_class_cdc_acm_transmission_status = UX_FALSE;

#endif

		/* Check if there is a new data to send */
		if (UserTxBufPtrOut != UserTxBufPtrIn)
		{
			/* Check buffer overflow and Rollback */
			if (UserTxBufPtrOut > UserTxBufPtrIn)
			{
				buffsize = APP_RX_DATA_SIZE - UserTxBufPtrOut;
			}
			else
			{
				/* Calculate data size */
				buffsize = UserTxBufPtrIn - UserTxBufPtrOut;
			}

			/* Copy UserTxBufPtrOut in buffptr */
			buffptr = UserTxBufPtrOut;

			/* Send data over the class cdc_acm_write */

			//    	  for (uint8_t i = 0; i < buffsize; i++){
			////    		  printf("Return: %d \n", UserTxBufferFS[buffptr + i]);
			//    		  if (UserTxBufferFS[buffptr + i] == 0x07){
			//    			  HAL_GPIO_TogglePin(LED_BUILTIN_GPIO_Port,	LED_BUILTIN_Pin);
			//    		  }
			//    	  }

			if (ux_device_class_cdc_acm_write(cdc_acm, (UCHAR *)(&UserTxBufferFS[buffptr]),
					buffsize, &actual_length) == UX_SUCCESS)
			{
				/* Increment the UserTxBufPtrOut pointer */
				UserTxBufPtrOut += buffsize;

				/* Rollback UserTxBufPtrOut if it equal to APP_TX_DATA_SIZE */
				if (UserTxBufPtrOut == APP_TX_DATA_SIZE)
				{
					UserTxBufPtrOut = 0;
				}
			}

		}
	}
}

/**
 * @brief  Tx Transfer completed callback.
 * @param  huart UART handle.
 * @retval none
 */
void HAL_UART_TxCpltCallback(UART_HandleTypeDef *huart)
{
	/* Set TX_NEW_TRANSMITTED_DATA flag */
	if (tx_event_flags_set(&EventFlag, TX_NEW_TRANSMITTED_DATA, TX_OR) != TX_SUCCESS)
	{
		Error_Handler();
	}
}

/**
 * @brief  Rx Transfer completed callback
 * @param  huart: UART handle
 * @retval none
 */
void HAL_UART_RxCpltCallback(UART_HandleTypeDef *huart)
{
	/* Increment the UserTxBufPtrIn pointer */
	UserTxBufPtrIn++;

	/* Rollback the UserTxBufPtrIn if it equal to APP_TX_DATA_SIZE */
	if (UserTxBufPtrIn == APP_TX_DATA_SIZE)
	{
		UserTxBufPtrIn = 0;
	}

	/* Set RX_NEW_RECEIVED_DATA flag */
	if (tx_event_flags_set(&EventFlag, RX_NEW_RECEIVED_DATA, TX_OR) != TX_SUCCESS)
	{
		Error_Handler();
	}

	/* Start another reception: provide the buffer pointer with offset and the buffer size */
	if (HAL_UART_Receive_IT(uart_handler, (uint8_t *)UserTxBufferFS + UserTxBufPtrIn, 1) != HAL_OK)
	{
		/* Transfer error in reception process */
		Error_Handler();
	}
}

/**
 * @brief  UART error callbacks
            Transfer error occurred in reception and/or transmission process.
 * @param  UartHandle: UART handle
 * @retval none
 */
void HAL_UART_ErrorCallback(UART_HandleTypeDef *UartHandle)
{
	//  Error_Handler();

	/* Invalidate the last packet if a framing error occurs */
	//	if (UartHandle->ErrorCode == (HAL_UART_ERROR_FE | UartHandle->ErrorCode)){
	//		UserTxBufPtrIn--;
	//		if (UserTxBufPtrIn <= 0){
	//			UserTxBufPtrIn = 0;
	//		}
	//	}
	//	printf("Error: %c\n", *UartHandle->pRxBuffPtr);

	//	if(*UartHandle->pRxBuffPtr == '\0'){
	//		UserTxBufPtrIn--;
	//		if (UserTxBufPtrIn <= 0){
	//			UserTxBufPtrIn = 0;
	//		}
	//	}

	//	}
}

/**
 * @brief  USBD_CDC_VCP_Config
            Configure the COM Port with the parameters received from host.
 * @param  UX_SLAVE_CLASS_CDC_ACM_LINE_CODING_PARAMETER: linecoding struct.
 * @param  CDC_VCP_LineCoding: CDC VCP line coding.
 * @retval none
 */
static VOID USBD_CDC_VCP_Config(UX_SLAVE_CLASS_CDC_ACM_LINE_CODING_PARAMETER
		*CDC_VCP_LineCoding)
{
	/* Deinitialization UART */
	if (HAL_UART_DeInit(uart_handler) != HAL_OK)
	{
		/* Deinitialization Error */
		Error_Handler();
	}

	/* Check stop bit parameter */
	switch (CDC_VCP_LineCoding->ux_slave_class_cdc_acm_parameter_stop_bit)
	{
	case 0:

		/* Set the UART Stop bit to 1 */
		uart_handler->Init.StopBits = UART_STOPBITS_1;

		break;

	case 2:

		/* Set the UART Stop bit to 2 */
		uart_handler->Init.StopBits = UART_STOPBITS_2;

		break;

	default :

		/* By default set the UART Stop bit to 1 */
		uart_handler->Init.StopBits = UART_STOPBITS_1;

		break;
	}

	/* Check parity parameter */
	switch (CDC_VCP_LineCoding->ux_slave_class_cdc_acm_parameter_parity)
	{
	case 0:

		/* Set the UART parity bit to none */
		uart_handler->Init.Parity = UART_PARITY_NONE;

		break;

	case 1:

		/* Set the UART parity bit to ODD */
		uart_handler->Init.Parity = UART_PARITY_ODD;

		break;

	case 2:

		/* Set the UART parity bit to even */
		uart_handler->Init.Parity = UART_PARITY_EVEN;

		break;

	default :

		/* By default set the UART parity bit to none */
		uart_handler->Init.Parity = UART_PARITY_NONE;

		break;
	}

	/* Set the UART data type : only 8bits and 9bits is supported */
	switch (CDC_VCP_LineCoding->ux_slave_class_cdc_acm_parameter_data_bit)
	{
	case 0x07:

		/* With this configuration a parity (Even or Odd) must be set */
		uart_handler->Init.WordLength = UART_WORDLENGTH_8B;

		break;

	case 0x08:

		if (uart_handler->Init.Parity == UART_PARITY_NONE)
		{
			uart_handler->Init.WordLength = UART_WORDLENGTH_8B;
		}
		else
		{
			uart_handler->Init.WordLength = UART_WORDLENGTH_9B;
		}

		break;

	default :

		uart_handler->Init.WordLength = UART_WORDLENGTH_8B;

		break;
	}

	/* Get the UART baudrate from VCP */
	uart_handler->Init.BaudRate = CDC_VCP_LineCoding->ux_slave_class_cdc_acm_parameter_baudrate;

	/* Set the UART Hw flow control to none */
	uart_handler->Init.HwFlowCtl = UART_HWCONTROL_NONE;

	/* Set the UART mode */
	uart_handler->Init.Mode = UART_MODE_TX_RX;

	/* Set the UART sampling */
	uart_handler->Init.OverSampling = UART_OVERSAMPLING_16;

	/* Initialization UART */
	if (HAL_UART_Init(uart_handler) != HAL_OK)
	{
		/* Initialization Error */
		Error_Handler();
	}

	/* Start reception: provide the buffer pointer with offset and the buffer size */
	HAL_UART_Receive_IT(uart_handler, (uint8_t *)(UserTxBufferFS + UserTxBufPtrIn), 1);
}
/* USER CODE END 1 */
