ben5049/Robotics-101-Devkit/STM32 Firmware/USB-UART Bridge Test/USBX/App/app_usbx_device.h

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
/* Define to prevent recursive inclusion -------------------------------------*/
#ifndef __APP_USBX_DEVICE_H__
#define __APP_USBX_DEVICE_H__

#ifdef __cplusplus
extern "C" {
#endif

/* Includes ------------------------------------------------------------------*/
#include "ux_api.h"
#include "ux_device_cdc_acm.h"
#include "ux_device_descriptors.h"
#include "app_azure_rtos_config.h"
#include "ux_dcd_stm32.h"

/* Exported types ------------------------------------------------------------*/
/* USER CODE BEGIN ET */

extern TX_EVENT_FLAGS_GROUP EventFlag;

/* USER CODE END ET */

/* Exported constants --------------------------------------------------------*/
#define USBX_DEVICE_MEMORY_STACK_SIZE       14*1024

#define UX_DEVICE_APP_THREAD_STACK_SIZE   2*1024
#define UX_DEVICE_APP_THREAD_PRIO         20

/* USER CODE BEGIN EC */
#define UX_DEVICE_CDC_ACM_THREAD_STACK_SIZE  1024
#define UX_DEVICE_CDC_ACM_THREAD_PRIO        22
/* USER CODE END EC */

/* Exported macro ------------------------------------------------------------*/
/* Exported functions prototypes ---------------------------------------------*/
UINT MX_USBX_Device_Init(VOID *memory_ptr);

/* USER CODE BEGIN EFP */
void MX_USB_Device_Init(void);
/* USER CODE END EFP */

/* USER CODE BEGIN PD */

#ifndef UX_DEVICE_CDC_ACM_THREAD_NAME
#define UX_DEVICE_CDC_ACM_THREAD_NAME  "USBX Device CDC ACM Thread"
#endif

#ifndef UX_DEVICE_CDC_ACM_THREAD_PREEMPTION_THRESHOLD
#define UX_DEVICE_CDC_ACM_THREAD_PREEMPTION_THRESHOLD  UX_DEVICE_CDC_ACM_THREAD_PRIO
#endif

#ifndef UX_DEVICE_CDC_ACM_THREAD_TIME_SLICE
#define UX_DEVICE_CDC_ACM_THREAD_TIME_SLICE  TX_NO_TIME_SLICE
#endif

#ifndef UX_DEVICE_CDC_ACM_THREAD_START_OPTION
#define UX_DEVICE_CDC_ACM_THREAD_START_OPTION  TX_AUTO_START
#endif

/* USER CODE END PD */
#ifndef UX_DEVICE_APP_THREAD_NAME
#define UX_DEVICE_APP_THREAD_NAME  "USBX Device App Main Thread"
#endif

#ifndef UX_DEVICE_APP_THREAD_PREEMPTION_THRESHOLD
#define UX_DEVICE_APP_THREAD_PREEMPTION_THRESHOLD  UX_DEVICE_APP_THREAD_PRIO
#endif

#ifndef UX_DEVICE_APP_THREAD_TIME_SLICE
#define UX_DEVICE_APP_THREAD_TIME_SLICE  TX_NO_TIME_SLICE
#endif

#ifndef UX_DEVICE_APP_THREAD_START_OPTION
#define UX_DEVICE_APP_THREAD_START_OPTION  TX_AUTO_START
#endif

#ifdef __cplusplus
}
#endif
#endif /* __APP_USBX_DEVICE_H__ */
