ben5049/Robotics-101-Devkit/(commit log)

2023-07-05 Added PCB and STM32 firmware
    [101 PCB.kicad_pcb, 101 PCB.kicad_sch, 1760510000.stp, DRV8837DSGR.stp, ESP32-WROVER-I--3DModel-STEP-56544.STEP, STM32G030F6P6.stp, TPS563202DRLR.stp, TYPE-C-31-M-12.step]
2023-07-07 Board layout done
    [101 PCB.kicad_pcb, 101 PCB.kicad_sch, DMP3028LFDE-13.STEP]
2023-09-11 Firmware working
    [101 PCB-B_Cu.gbr, 101 PCB-B_Mask.gbr, 101 PCB-B_Paste.gbr, 101 PCB-B_Silkscreen.gbr, 101 PCB-Edge_Cuts.gbr, 101 PCB-F_Cu.gbr, 101 PCB-F_Mask.gbr, 101 PCB-F_Paste.gbr]
