ben5049/Robotics-101-Devkit/(notices)

Notices in the files:
STM32 Firmware/Robotics 101 Devkit Coprocessor/Core/Src/main.c:
Copyright (c) 2023 STMicroelectronics.
All rights reserved.
This software is licensed under terms that can be found in the LICENSE file
STM32 Firmware/Robotics 101 Devkit Coprocessor/USBX/App/ux_device_descriptors.c:
Copyright (c) 2020-2021 STMicroelectronics.
